centrevillage/nts1-groove-pad/hardware/pcb/projects/groove-pad-ctrl/groove-pad-ctrl.kicad_pcb

## KiCad design hardware/pcb/projects/groove-pad-ctrl/groove-pad-ctrl.kicad_pcb (2020-03-11)

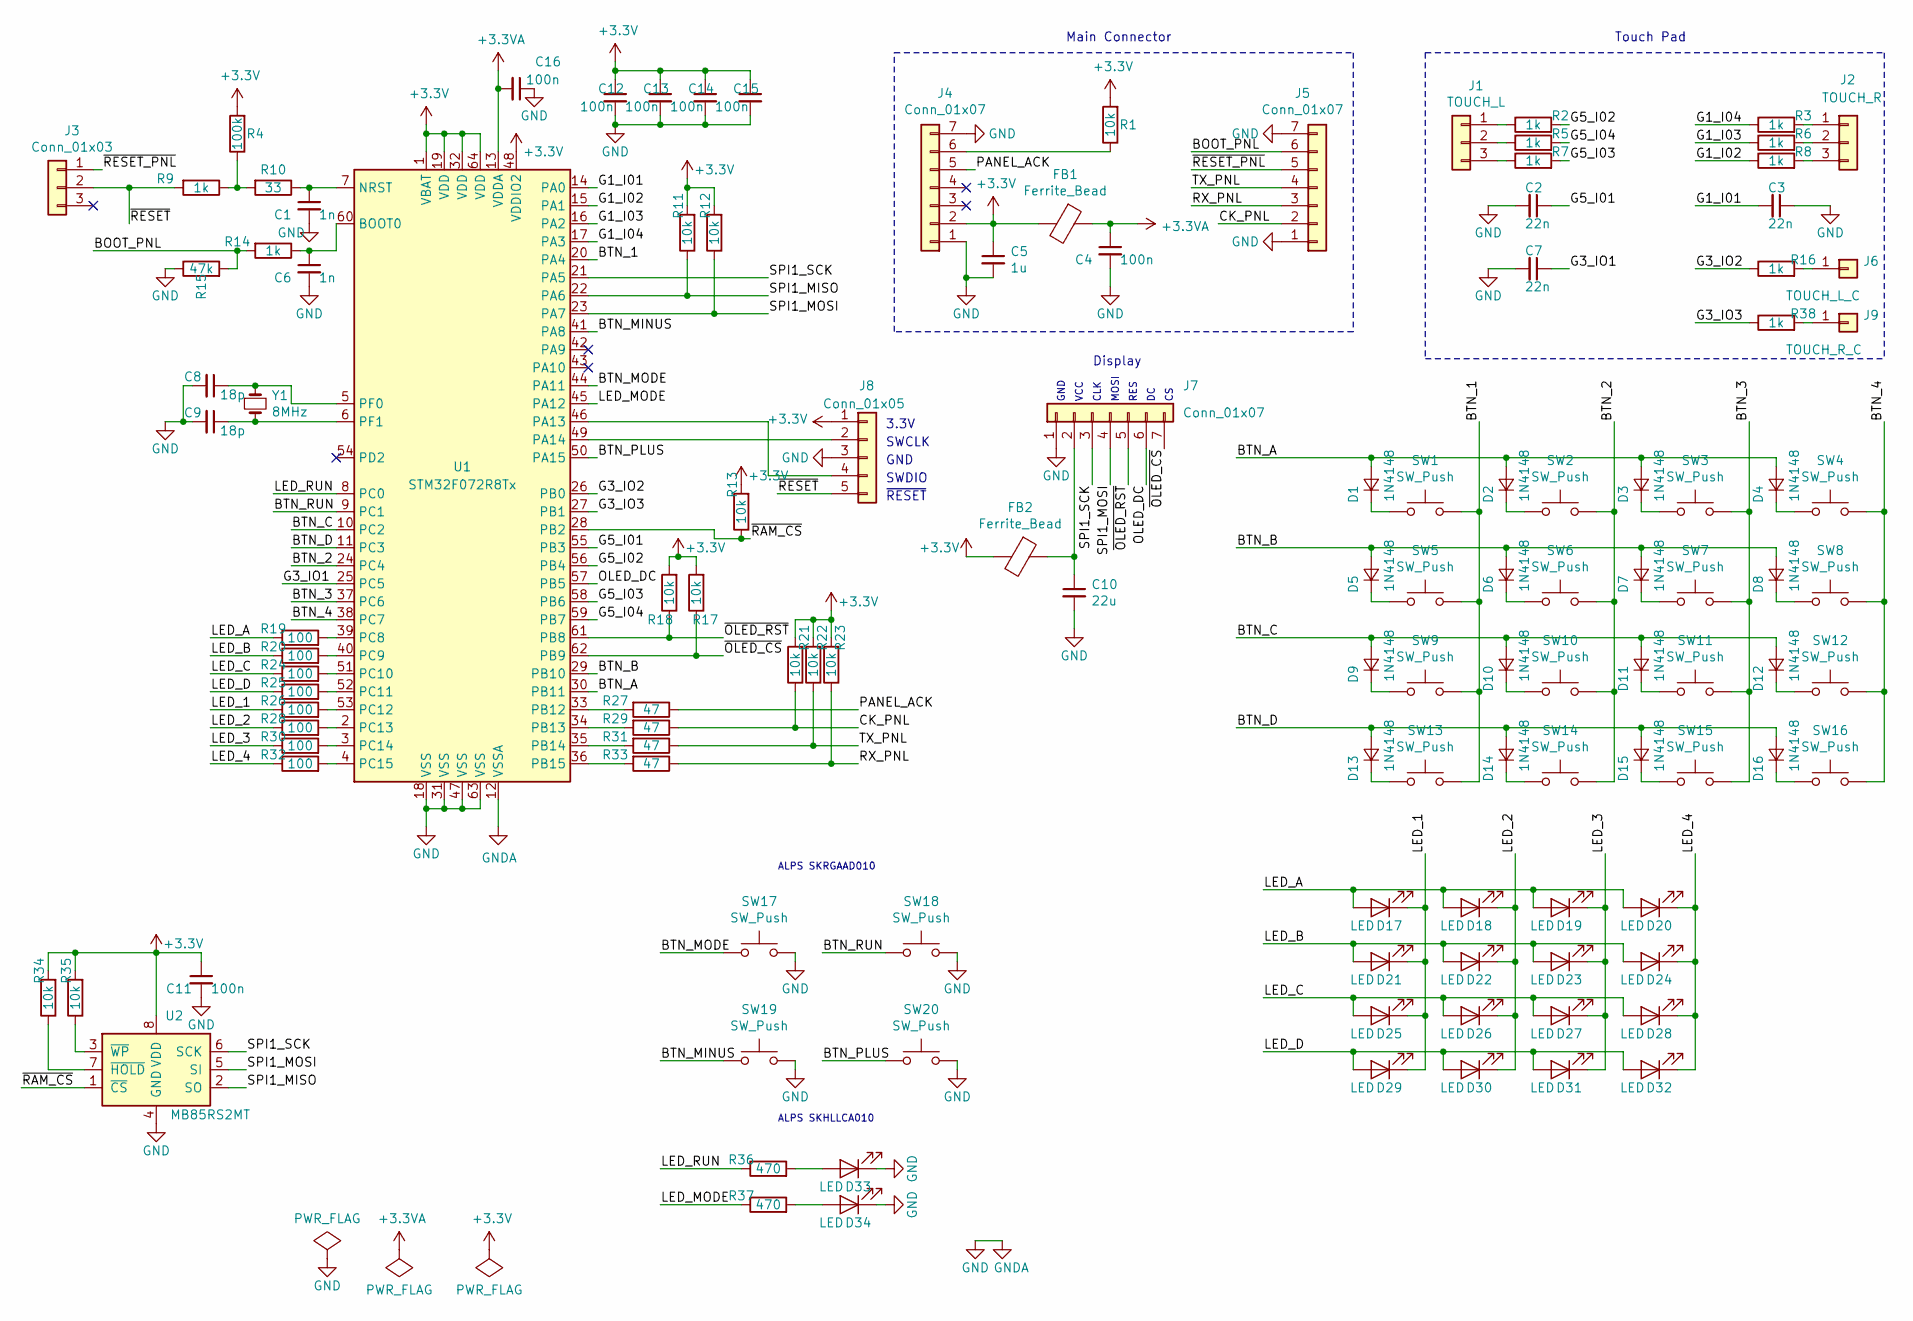
[picture p1: schematic groove-pad-ctrl.sch]

Parts:
C1, C6: 1n; C_0603_1608Metric
C2, C3, C7: 22n; C_0603_1608Metric
C4, C11, C12, C13, C14, C15, C16: 100n; C_0603_1608Metric
C5: 1u; C_1206_3216Metric
C8, C9: 18p; C_0603_1608Metric
C10: 22u; C_1206_3216Metric
D1, D2, D3, D4, D5, D6, D7, D8, D9, D10, D11, D12, D13, D14, D15, D16: 1N4148; SOD-123_mod2
D17, D18, D19, D20, D21, D22, D23, D24, D25, D26, D27, D28, D29, D30, D31, D32, D33, D34: LED; LED_0603_1608Metric_Castellated
FB1, FB2: Ferrite_Bead; R_0805_2012Metric
J1: TOUCH_L; CassettePad
J2: TOUCH_R; CassettePad
J3: Conn_01x03; PinHeader_1x03_P2.54mm_Vertical
J4, J5, J7: Conn_01x07; PinHeader_1x07_P2.54mm_Vertical
J6: TOUCH_L_C; PAD_CENTER
J8: Conn_01x05; PinHeader_1x05_P2.54mm_Vertical
J9: TOUCH_R_C; PAD_CENTER
R1, R11, R12, R13, R17, R18, R21, R22, R23, R34, R35: 10k; R_0603_1608Metric
R2, R3, R5, R6, R7, R8, R9, R14, R16, R38: 1k; R_0603_1608Metric
R4: 100k; R_0603_1608Metric
R10: 33; R_0603_1608Metric
R15: 47k; R_0603_1608Metric
R19, R20, R24, R25, R26, R28, R30, R32: 100; R_0603_1608Metric
R27, R29, R31, R33: 47; R_0603_1608Metric
R36, R37: 470; R_0603_1608Metric
SW1, SW2, SW3, SW4, SW5, SW6, SW7, SW8, SW9, SW10, SW11, SW12, SW13, SW14, SW15, SW16, SW17, SW18: SW_Push; SW_Tactile_SKRH
SW19, SW20: SW_Push; SW_Tactile_SPST_Angled_ALPS_SKHLL
U1: STM32F072R8Tx; LQFP-64_10x10mm_P0.5mm
U2: MB85RS2MT
Y1: 8MHz; Crystal_SMD_Abracon_ABM3-2pin_5.0x3.2mm_hand

Connections:
+3.3VA: C4.1, C16.2, FB1.1, U1.13 (VDDA)
+3V3: C5.1, C11.1, C12.1, C13.1, C14.1, C15.1, FB1.2, FB2.2, J4.2, J8.1, R1.2, R4.2, R11.2, R12.2, R13.2, R17.2, R18.2, R21.2, R22.2, R23.2, R34.2, R35.2, U1.1 (VBAT), U1.19 (VDD), U1.32 (VDD), U1.48 (VDDIO2), U1.64 (VDD), U2.8 (VDD)
/BOOT_PNL: J5.6, R14.2, R15.2
/BTN_1: SW1.2, SW5.2, SW9.2, SW13.2, U1.20 (PA4)
/BTN_2: SW2.2, SW6.2, SW10.2, SW14.2, U1.24 (PC4)
/BTN_3: SW3.2, SW7.2, SW11.2, SW15.2, U1.37 (PC6)
/BTN_4: SW4.2, SW8.2, SW12.2, SW16.2, U1.38 (PC7)
/BTN_A: D1.2 (A), D2.2 (A), D3.2 (A), D4.2 (A), U1.30 (PB11)
/BTN_B: D5.2 (A), D6.2 (A), D7.2 (A), D8.2 (A), U1.29 (PB10)
/BTN_C: D9.2 (A), D10.2 (A), D11.2 (A), D12.2 (A), U1.10 (PC2)
/BTN_D: D13.2 (A), D14.2 (A), D15.2 (A), D16.2 (A), U1.11 (PC3)
/BTN_MINUS: SW19.1, U1.41 (PA8)
/BTN_MODE: SW17.1, U1.44 (PA11)
/BTN_PLUS: SW20.1, U1.50 (PA15)
/BTN_RUN: SW18.1, U1.9 (PC1)
/CK_PNL: J5.2, R21.1, R29.1
/G1_I01: C3.2, U1.14 (PA0)
/G1_I02: R8.1, U1.15 (PA1)
/G1_I03: R6.1, U1.16 (PA2)
/G1_I04: R3.1, U1.17 (PA3)
/G3_IO1: C7.1, U1.25 (PC5)
/G3_IO2: R16.1, U1.26 (PB0)
/G3_IO3: R38.1, U1.27 (PB1)
/G5_I01: C2.1, U1.55 (PB3)
/G5_I02: R2.2, U1.56 (PB4)
/G5_I03: R7.2, U1.58 (PB6)
/G5_I04: R5.2, U1.59 (PB7)
/LED_1: D17.1 (K), D21.1 (K), D25.1 (K), D29.1 (K), R26.1
/LED_2: D18.1 (K), D22.1 (K), D26.1 (K), D30.1 (K), R28.1
/LED_3: D19.1 (K), D23.1 (K), D27.1 (K), D31.1 (K), R30.1
/LED_4: D20.1 (K), D24.1 (K), D28.1 (K), D32.1 (K), R32.1
/LED_A: D17.2 (A), D18.2 (A), D19.2 (A), D20.2 (A), R19.1
/LED_B: D21.2 (A), D22.2 (A), D23.2 (A), D24.2 (A), R20.1
/LED_C: D25.2 (A), D26.2 (A), D27.2 (A), D28.2 (A), R24.1
/LED_D: D29.2 (A), D30.2 (A), D31.2 (A), D32.2 (A), R25.1
/LED_MODE: R37.1, U1.45 (PA12)
/LED_RUN: R36.1, U1.8 (PC0)
/OLED_DC: J7.6, U1.57 (PB5)
/PANEL_ACK: J4.5, R27.1
/RX_PNL: J5.3, R23.1, R33.1
/SPI1_MISO: R11.1, U1.22 (PA6), U2.2 (SO)
/SPI1_MOSI: J7.4, R12.1, U1.23 (PA7), U2.5 (SI)
/SPI1_SCK: J7.3, U1.21 (PA5), U2.6 (SCK)
/TX_PNL: J5.4, R22.1, R31.1
/~OLED_CS: J7.7, R17.1, U1.62 (PB9)
/~OLED_RST: J7.5, R18.1, U1.61 (PB8)
/~RAM_CS: R13.1, U1.28 (PB2), U2.1 (~CS)
/~RESET: J3.2, J8.5, R9.2
/~RESET_PNL: J3.1, J5.5
GND: C1.2, C2.2, C3.1, C4.2, C5.2, C6.2, C7.2, C8.2, C9.2, C10.2, C11.2, C12.2, C13.2, C14.2, C15.2, C16.1, D33.1 (K), D34.1 (K), J4.1, J4.7, J5.1, J5.7, J7.1, J8.3, R15.1, SW17.2, SW18.2, SW19.2, SW20.2, U1.12 (VSSA), U1.18 (VSS), U1.31 (VSS), U1.47 (VSS), U1.63 (VSS), U2.4 (GND)
unnamed: C1.1, R10.1, U1.7 (NRST)
unnamed: C6.1, R14.1, U1.60 (BOOT0)
unnamed: C8.1, U1.5 (PF0), Y1.1
unnamed: C9.1, U1.6 (PF1), Y1.2
unnamed: C10.1, FB2.1, J7.2
unnamed: D1.1 (K), SW1.1
unnamed: D2.1 (K), SW2.1
unnamed: D3.1 (K), SW3.1
unnamed: D4.1 (K), SW4.1
unnamed: D5.1 (K), SW5.1
unnamed: D6.1 (K), SW6.1
unnamed: D7.1 (K), SW7.1
unnamed: D8.1 (K), SW8.1
unnamed: D9.1 (K), SW9.1
unnamed: D10.1 (K), SW10.1
unnamed: D11.1 (K), SW11.1
unnamed: D12.1 (K), SW12.1
unnamed: D13.1 (K), SW13.1
unnamed: D14.1 (K), SW14.1
unnamed: D15.1 (K), SW15.1
unnamed: D16.1 (K), SW16.1
unnamed: D33.2 (A), R36.2
unnamed: D34.2 (A), R37.2
unnamed: J1.1, R2.1
unnamed: J1.2, R5.1
unnamed: J1.3, R7.1
unnamed: J2.1, R3.2
unnamed: J2.2, R6.2
unnamed: J2.3, R8.2
unnamed: J4.6, R1.1
unnamed: J6.1, R16.2
unnamed: J8.2, U1.49 (PA14)
unnamed: J8.4, U1.46 (PA13)
unnamed: J9.1, R38.2
unnamed: R4.1, R9.1, R10.2
unnamed: R19.2, U1.39 (PC8)
unnamed: R20.2, U1.40 (PC9)
unnamed: R24.2, U1.51 (PC10)
unnamed: R25.2, U1.52 (PC11)
unnamed: R26.2, U1.53 (PC12)
unnamed: R27.2, U1.33 (PB12)
unnamed: R28.2, U1.2 (PC13)
unnamed: R29.2, U1.34 (PB13)
unnamed: R30.2, U1.3 (PC14)
unnamed: R31.2, U1.35 (PB14)
unnamed: R32.2, U1.4 (PC15)
unnamed: R33.2, U1.36 (PB15)
unnamed: R34.1, U2.7 (~HOLD)
unnamed: R35.1, U2.3 (~WP)

Notes on the sheet:
Main Connector
SWCLK
3.3V
SWDIO
GND
Touch Pad
Display
VCC
CLK
MOSI
RES
~RESET
ALPS SKHLLCA010
ALPS SKRGAAD010

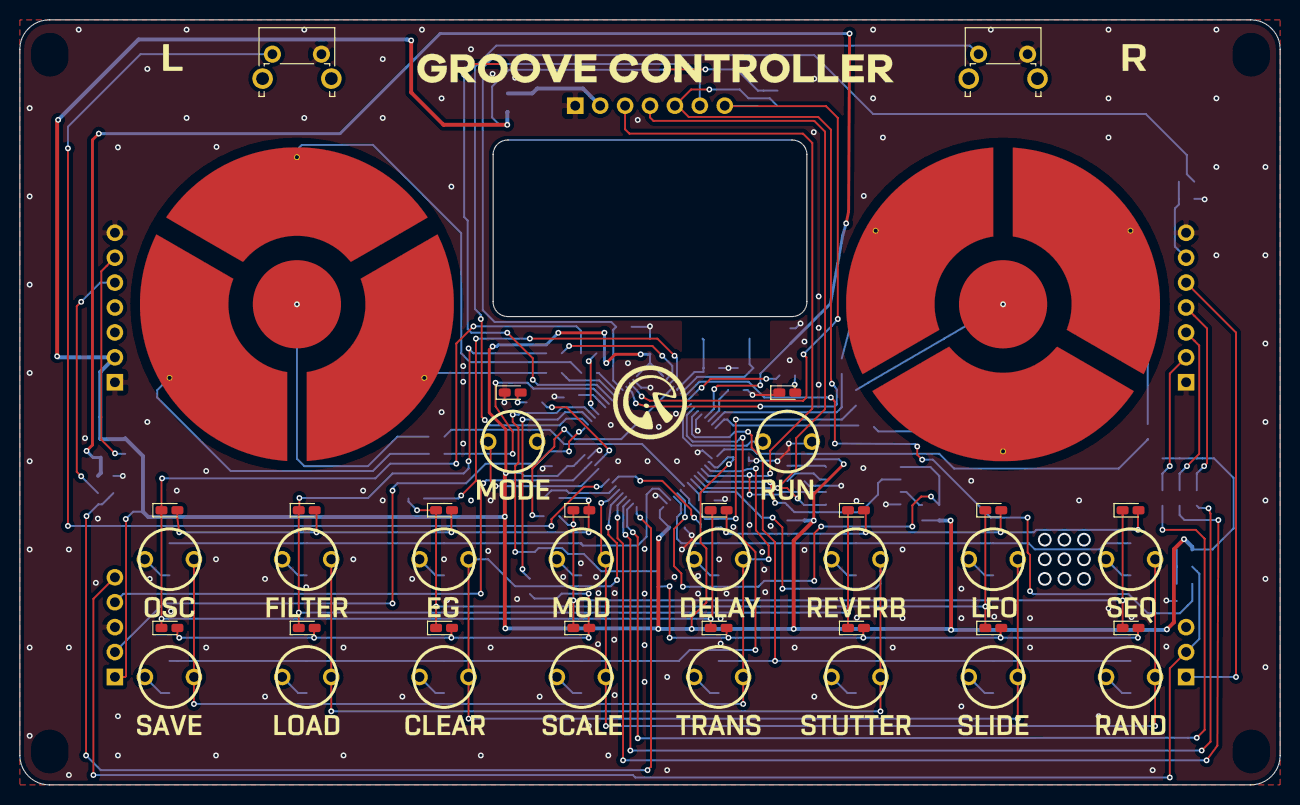
[picture p2: board groove-pad-ctrl.kicad_pcb from above]

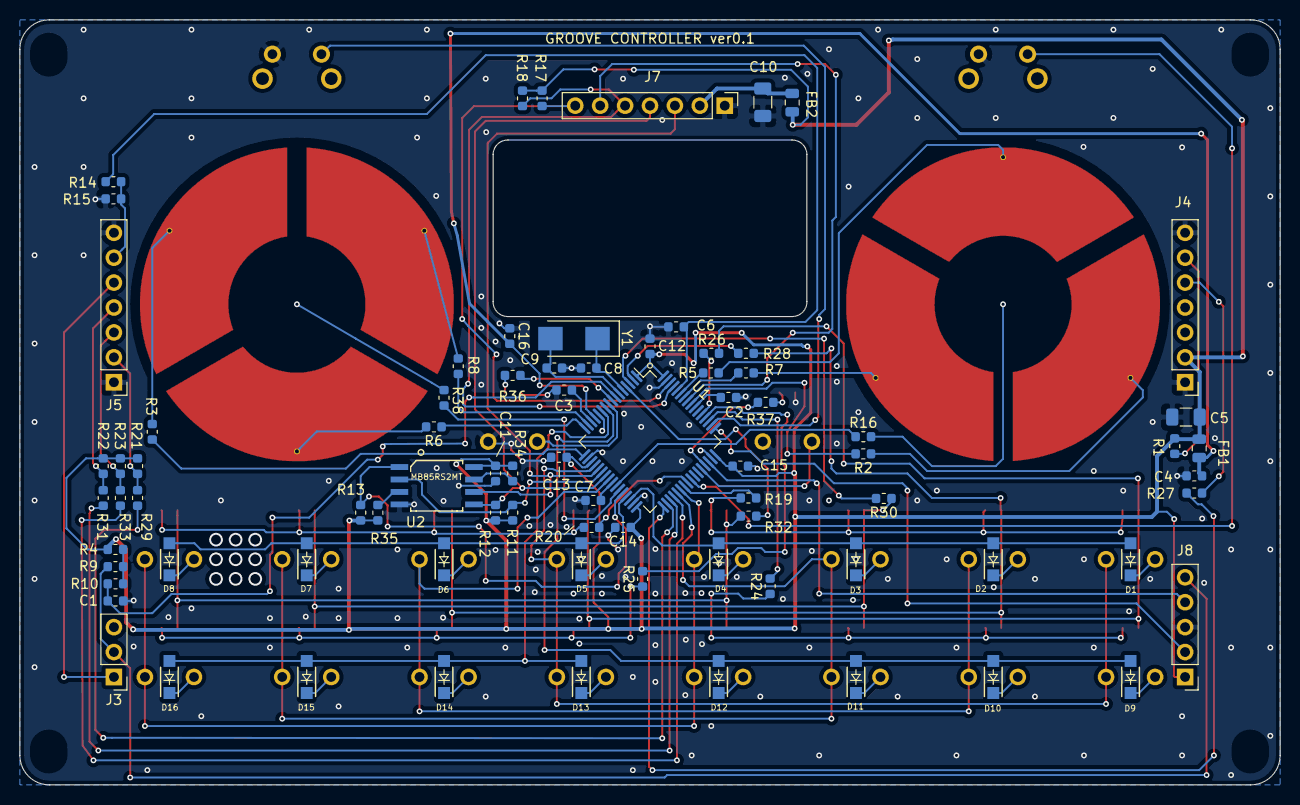
[picture p3: board groove-pad-ctrl.kicad_pcb from below]

Board: 2 copper layers, 128.5 x 78.0 mm, 122 parts (80 on the bottom side), 99 nets.
