centrevillage/nts1-groove-pad/firmware/src/app_button.hpp

#ifndef APP_BUTTON_H
#define APP_BUTTON_H

#include <igb_stm32/periph/gpio.hpp>
#include <igb_sdk/ui/button.hpp>
#include <functional>
#include <tuple>

// 危険は承知の上・・・
using namespace igb::stm32;
using namespace igb::sdk;

enum class AppBtnID : uint8_t {
  OSC = 0, PARAM, FILTER, EG, MOD, DELAY, REVERB, ARP,
  SAVE, LOAD, CLEAR, GLOBAL, SCALE, TRANS, STUTTER, LFO,
  SEQ, RUN, L, R,

  SIZE
};

struct AppButtons {
  // こう書けたらいいのに！
  //using namespace igb_stm32;
  //using namespace igb_sdk;

  GpioPort port_a { GpioType::gpioa };
  GpioPort port_b { GpioType::gpiob };
  GpioPort port_c { GpioType::gpioc };

  ButtonSingle<GpioPin> seq_btn { GpioPin::newPin(GpioPinType::pa11) };
  ButtonSingle<GpioPin> run_btn { GpioPin::newPin(GpioPinType::pc1) };
  ButtonSingle<GpioPin> l_btn   { GpioPin::newPin(GpioPinType::pa8) };
  ButtonSingle<GpioPin> r_btn   { GpioPin::newPin(GpioPinType::pa15) };

  ButtonMatrix<GpioPin, 4, GpioPin, 4> btn_matrix {
    .in_pins = {
      GpioPin::newPin(GpioPinType::pa4),
      GpioPin::newPin(GpioPinType::pc4),
      GpioPin::newPin(GpioPinType::pc6),
      GpioPin::newPin(GpioPinType::pc7)
    },
    .out_pins = {
      GpioPin::newPin(GpioPinType::pb11),
      GpioPin::newPin(GpioPinType::pb10),
      GpioPin::newPin(GpioPinType::pc2),
      GpioPin::newPin(GpioPinType::pc3)
    }
  };

  uint32_t state_bits = 0;
  std::function<void(AppBtnID, bool)> on_change;

  void init() {
    port_a.enable();
    port_b.enable();
    port_c.enable();

    seq_btn.pin.initInput(GpioPullMode::up, GpioSpeedMode::high);
    run_btn.pin.initInput(GpioPullMode::up, GpioSpeedMode::high);
    l_btn.pin.initInput(GpioPullMode::up, GpioSpeedMode::high);
    r_btn.pin.initInput(GpioPullMode::up, GpioSpeedMode::high);

    for (const auto& in_pin : btn_matrix.in_pins) {
      in_pin.initInput(GpioPullMode::no, GpioSpeedMode::high);
    }
    for (const auto& out_pin : btn_matrix.out_pins) {
      out_pin.initOutput(GpioOutputMode::pushpull, GpioSpeedMode::high);
    }

    btn_matrix.init();
  }

  inline bool _isOn4Matrix(AppBtnID btn_id) {
    std::tuple<uint8_t, uint8_t> in_out_pin_idx {0, 0};

    switch (btn_id) {
      case AppBtnID::OSC:
        in_out_pin_idx = {0, 0}; break;
      case AppBtnID::PARAM:
        in_out_pin_idx = {1, 0}; break;
      case AppBtnID::FILTER:
        in_out_pin_idx = {2, 0}; break;
      case AppBtnID::EG:
        in_out_pin_idx = {3, 0}; break;
      case AppBtnID::MOD:
        in_out_pin_idx = {0, 1}; break;
      case AppBtnID::DELAY:
        in_out_pin_idx = {1, 1}; break;
      case AppBtnID::REVERB:
        in_out_pin_idx = {2, 1}; break;
      case AppBtnID::ARP:
        in_out_pin_idx = {3, 1}; break;
      case AppBtnID::SAVE:
        in_out_pin_idx = {0, 2}; break;
      case AppBtnID::LOAD:
        in_out_pin_idx = {1, 2}; break;
      case AppBtnID::CLEAR:
        in_out_pin_idx = {2, 2}; break;
      case AppBtnID::GLOBAL:
        in_out_pin_idx = {3, 2}; break;
      case AppBtnID::SCALE:
        in_out_pin_idx = {0, 3}; break;
      case AppBtnID::TRANS:
        in_out_pin_idx = {1, 3}; break;
      case AppBtnID::STUTTER:
        in_out_pin_idx = {2, 3}; break;
      case AppBtnID::LFO:
        in_out_pin_idx = {3, 3}; break;
      default:
        break;
    }
    return btn_matrix.isOn(std::get<0>(in_out_pin_idx), std::get<1>(in_out_pin_idx));
  }

  // TODO: ボタンと対応するインデックスの関連づけ、もっとシンプルに定義できる様にしたい
  bool isOn(AppBtnID btn_id) {
    bool on = false;

    switch (btn_id) {
      case AppBtnID::OSC:
      case AppBtnID::PARAM:
      case AppBtnID::FILTER:
      case AppBtnID::EG:
      case AppBtnID::MOD:
      case AppBtnID::DELAY:
      case AppBtnID::REVERB:
      case AppBtnID::ARP:
      case AppBtnID::SAVE:
      case AppBtnID::LOAD:
      case AppBtnID::CLEAR:
      case AppBtnID::GLOBAL:
      case AppBtnID::SCALE:
      case AppBtnID::TRANS:
      case AppBtnID::STUTTER:
      case AppBtnID::LFO:
        on = _isOn4Matrix(btn_id);
        break;
      case AppBtnID::SEQ:
        on = seq_btn.isOn(); break;
      case AppBtnID::RUN:
        on = run_btn.isOn(); break;
      case AppBtnID::L:
        on = l_btn.isOn(); break;
      case AppBtnID::R:
        on = r_btn.isOn(); break;
      default:
        break;
    }

    return on;
  }

  void process() {
    seq_btn.process();
    run_btn.process();
    l_btn.process();
    r_btn.process();
    btn_matrix.process();
    uint32_t new_bits = 0;
    for (uint8_t i = 0; i < static_cast<uint8_t>(AppBtnID::SIZE); ++i) {
      if (isOn(static_cast<AppBtnID>(i))) {
        new_bits |= (uint32_t)1 << i;
      }
    }
    if (state_bits != new_bits) {
      if (on_change) {
        uint32_t diff_bits = state_bits ^ new_bits;
        state_bits = new_bits;
        for (uint8_t i = 0; i < static_cast<uint8_t>(AppBtnID::SIZE); ++i) {
          if (diff_bits & ((uint32_t)1 << i)) {
            on_change(static_cast<AppBtnID>(i), !!(new_bits & ((uint32_t)1 << i)));
          }
        }
      }
    }
  }
};

#endif /* APP_BUTTON_H */
