centrevillage/nts1-groove-pad/firmware/src/main.h

#ifndef __N1GP_MAIN_H__
#define __N1GP_MAIN_H__

#include <string.h>
#include "nts1_iface.h"
//#include "stm32_def.h"
#include "stm32f0xx.h"
#include "stm32_pinconfig.h"
#include "debug.h"
#include "common.h"
#include "version.h"
#include "user_conf.h"

#define FORCE_INLINE static inline __attribute__((always_inline, optimize("Ofast"))) 

#endif /* __N1GP_MAIN_H__ */
