centrevillage/nts1-groove-pad/firmware/src/app_input/seq_ampeg.hpp

#ifndef N1GP_APP_INPUT_SEQ_AMPEG_H
#define N1GP_APP_INPUT_SEQ_AMPEG_H

#include <app_input/base.hpp>

struct AppInputSeqAmpeg {
  inline void init() {
    app_screen.changeMode(AppScreenSeq {});
    seq.changeTrack(AppTrackType::ampeg);
  }
  inline void touch(uint8_t touch_idx, bool on) {
  }
  inline bool button(AppBtnID id, bool on) {
    return false;
  }
  inline void incValueL(int16_t inc_value) {
  }
  inline void incValueR(int16_t inc_value) {
  }
  inline void refresh() {
    if (!app_screen.isMode<AppScreenSeq>()) { return; }
    auto& screen_mode = app_screen.getMode<AppScreenSeq>();
    screen_mode.setTitle("SEQ:EG", 16);
  }
};

#endif /* N1GP_APP_INPUT_SEQ_AMPEG_H */
