centrevillage/nts1-groove-pad/(commit log)

2020-02-21 ver 0.1
    [groove-pad-ctrl.csv, groove-pad-ctrl.kicad_pcb, groove-pad-ctrl.sch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]
2020-03-11 change MCU
    [groove-pad-ctrl.kicad_pcb, groove-pad-ctrl.sch]
2020-04-11 OLEDが動かない・・・・
2020-04-14 色々やったが相変わらずOLED動かん
2020-04-30 spi通信処理を見直したら画面が映るようになったが座標がへん？
2020-04-30 OLEDの実際のwidthは128pxじゃなくて130pxぽい？
2020-05-08 OLEDへのビットマップ描画テスト
2020-05-11 TSCの対応
2020-05-15 ボタン操作とLEDの点灯制御
2020-05-17 refactoring timer
2020-05-18 add Makefile (but not working...)
    [debug.c, event_buf.c, event_buf.h, handlers.c, main.cpp, main.h, nts1_iface.c, oled.cpp]
2020-05-26 NTS1本体からのパラメータ読み込み
2020-05-27 fix param name display
    [input.c, main.cpp, nts1_defs.c, screen.c, text.c, text.h]
2020-06-01 refactoring spi
2020-06-01 タッチパッドによる値の変更
2020-06-02 タッチ入力の不具合修正
2020-06-04 FRAMへのプリセット保存処理
2020-06-06 一時保存処理
2020-08-05 シーケンス入力処理(途中)
2020-08-12 シーケンス機能の抽象化と簡易実装
2020-08-12 ライブラリコードをlib以下に移動
2020-08-12 余分なusing宣言を削除
2020-08-14 GPIO周りの抽象化とライブラリ化（途中）
2020-08-16 bugfix for ButtonMatrix
2020-08-16 remove button.h/c
2020-08-23 ネーミングルールの統一化
2020-09-12 igb_stm32: add spi peripheral
2020-09-12 oled.cをLL非依存に
2020-09-12 ram.c(pp)をLL非依存にし、不要となったファイルを削除
2020-09-12 ledとpresetをLL非依存に
2020-09-29 igb namespace の構造変更
2020-10-04 LL依存箇所を完全削除
2020-10-09 入力処理のモダンC++化
2020-10-11 input周りのコードを分割
2020-10-14 screenのcpp化(途中)
2020-10-26 Timer -> Tim
2020-11-21 add led to sdk
2020-11-22 bugfix: fram lib spi issue
    [preset.cpp, ram.cpp, ram.h]
2020-11-22 igb_sdk を外部lib化
